AjoyDas76/Safe_Guard/vest/README.md

# 🦺 SafeGuard Vest for Industrial Workers

An IoT-based wearable safety vest powered by **ESP32**, **LoRa**, and a **solar charging system**.

## Features
- 🌡️ Environmental Monitoring (BME280)
- 📍 GPS Tracking (NEO-M8N)
- 🚶 Motion & Fall Detection (MPU6050)
- 📡 Long-range Communication (SX1278 RA-02 LoRa)
- 📲 GSM Emergency SOS SMS (SIM800L) — sends last GPS location on fall/SOS/high-temp alert
- ☀️ Solar Charging (DFRobot Solar Power Manager 5V)
- 🆘 SOS Emergency Button
- 🔋 Battery-powered wearable system

See [`VEST-CONNECTIONS.md`](./VEST-CONNECTIONS.md) for the full hardware wiring reference.

## Hardware
- ESP32 DevKit V1
- BME280
- MPU6050
- NEO-M8N GPS
- SX1278 RA-02
- SIM800L GSM
- 5V Flexible Solar Panel
- DFRobot Solar Power Manager 5V
- 18650 Li-ion Battery
- Active Buzzer
- SOS Push Button
- On/Off Switch

## Repository Structure
```
hardware/
firmware/
docs/
diagrams/
images/
results/
thesis/
datasheets/
```

## Development Roadmap
- [x] Phase 1 - Project Initialization
- [x] Phase 2 - BME280 Environmental Monitoring
- [x] Phase 3 - MPU6050 Motion & Fall Detection
- [x] Phase 4 - GPS Tracking System
- [x] Phase 5 - LoRa Communication System
- [x] Phase 6 - IoT Cloud Platform
- [x] Phase 7 - Mobile Application
- [x] Phase 8 - Smart Safety Features
- [x] Phase 9 - System Integration
- [ ] Phase 10 - Final Product Release

See `firmware/README.md` for the full phase-by-phase breakdown and status.

## Team
- Ajoy Das
- Shafiul Azam
- Ritu Biswas
- Abdullah Al Mamun
- Abdul Halim

## Project Progress

| Phase | Status |
| --- | --- |
| Phase 01 - Project Initialization | ✅ Completed |
| Phase 02 - BME280 Integartion | ✅ Completed |
| Phase 03 - MPU6050 Integration | ✅ Completed |
| Phase 04 - GPS Module Integration | ✅ Completed |
| Phase 05 - LoRa Integration | ✅ Completed |
| Phase 06 - IoT Cloud Platform | ✅ Completed |
| Phase 07 - Mobile Application | ✅ Completed |
| Phase 08 - Smart Safety Feature Integration | ✅ Completed |
| Phase 09 - Full System Integration | ✅ Completed |
| Phase 10 - Final Product Release | ⬜ Pending |

Roadmap
