AjoyDas76/Safe_Guard/final-project/README.md

# Final Project – SafeGuard Smart Industrial Safety System

This folder contains the combined, final-release deliverables for the complete **SafeGuard Smart Industrial Safety System**, integrating the **Smart Safety Vest** and **Smart Safety Helmet** into one final project package.

The purpose of this folder is to collect the materials that represent the **finished project as a whole**, rather than the individual development history of the vest and helmet sections.

## 📦 Final Project Contents

As the project is completed, this folder is intended to contain:

- 📄 **Final combined project report / thesis document**
- 🎞️ **Final presentation slides**
- 🏗️ **Consolidated system architecture diagram** covering the vest and helmet together
- 📋 **Final Bill of Materials (BOM)** for both sections
- 🧪 **Field-test results and performance summary**
- 📦 **Submission-ready project package**, such as a ZIP release
- 🎥 **Demo video links**, where applicable

## 🦺⛑️ Complete SafeGuard System

The final project represents the combined **Smart Industrial Safety System** consisting of:

- 🦺 Smart Safety Vest
- ⛑️ Smart Safety Helmet
- 📊 Combined system documentation
- 🏗️ Consolidated system architecture
- 📋 Final hardware and component documentation
- 🧪 Final testing and performance results
- 📦 Submission-ready project deliverables

## 📁 Repository Organization

The repository separates development work from the final combined deliverables:

```text
Safe_Guard/
│
├── vest/
│   └── Smart Safety Vest development
│
├── helmet/
│   └── Smart Safety Helmet development
│
└── final-project/
    └── Combined final-release deliverables
```

### `vest/`

Contains the working files for the **Smart Safety Vest**, including its firmware, wiring documentation, and phase-by-phase development history.

### `helmet/`

Contains the working files for the **Smart Safety Helmet**, including its firmware, wiring documentation, and phase-by-phase development history.

### `final-project/`

This folder is specifically reserved for the **final combined output** of the complete Smart Industrial Safety System.

## 🔄 Development vs Final Release

The `vest/` and `helmet/` folders remain the working areas for their respective sections.

Their development history, firmware, wiring documentation, and phase-by-phase work should remain organized within those folders.

The `final-project/` folder should contain only the materials required to represent and submit the **completed combined system**.

This separation keeps the repository organized while preserving the individual development history of both system sections.

## 🎓 Final Submission Package

When the project is ready for final submission, this folder should provide a single location for the major combined deliverables:

1. Final Project Report / Thesis
2. Final Presentation
3. Combined System Architecture
4. Final Bill of Materials
5. Field-Test and Performance Results
6. Submission-Ready Project Package
7. Demonstration Video Links, if available

## 📌 Project Status

The contents of this folder are intended to be populated and finalized as the complete **Smart Industrial Safety System (Vest + Helmet)** reaches its final submission stage.

> **Note:** `final-project/` is the final-release area. The `vest/` and `helmet/` folders remain the primary locations for their individual development files and phase-by-phase history.
