AjoyDas76/Safe_Guard/vest/firmware/Phase-08_Smart_Safety_Features/README.md

# Phase-08 Smart Safety Features

## Objective
Add the on-body safety hardware features to the worker unit: manual SOS button, audible/visual alarms, and power management (solar charging + battery monitoring), and finalize the safety module as a whole.

## Tasks

- [x] 8.1 SOS Button
- [x] 8.2 Buzzer Alarm
- [x] 8.3 LED Warning Indicator
- [x] 8.4 Battery Monitoring
- [x] 8.5 Power Management
- [x] 8.6 SIM800L SOS SMS (added beyond the original scope — moved here from the helmet; see Notes)
- [x] 8.7 Safety Module Finalization

## Components
- SOS Push Button
- Active Buzzer
- Status LED(s)
- SIM800L GSM module
- 18650 Li-ion Battery
- 5V Flexible Solar Panel
- DFRobot Solar Power Manager 5V

## Wiring
Finalized in `Phase-09_System_Integration/transmitter_final.ino` (pin numbers superseded the Phase 5 sketches' `BUTTON_PIN 4`):

| Feature | Pin |
|---|---|
| SOS Button (INPUT_PULLUP) | GPIO15 |
| Buzzer | GPIO12 |
| LED | GPIO13 |
| Battery monitor (ADC, via 2:1 voltage divider) | GPIO34 |
| SIM800L RX / TX | GPIO25 / GPIO27 |

Full reference: [`../../VEST-CONNECTIONS.md`](../../VEST-CONNECTIONS.md).

## Code
Implemented directly in `Phase-09_System_Integration/transmitter_final.ino` rather than as a separate standalone sketch — the alarm trigger condition (`mpuData.fall || sosActive || temp > 50.0`) drives the buzzer/LED and also triggers a SIM800L SOS SMS (with the worker's last GPS location) via `sendSOSMessage()`, cooldown-limited to 60s.

## Test Results
SOS button, buzzer, LED, and battery monitoring confirmed working as part of the finalized transmitter firmware. SIM800L SMS sending is implemented but **not yet confirmed end-to-end** — `EMERGENCY_NUMBER` in `transmitter_final.ino` is still a placeholder (`+8801XXXXXXXXX`) and needs a real number before this can be tested.

## Notes
- This phase merges what were previously two separate, empty placeholder folders (`Phase-06_Power_System` and `Phase-07_SOS`) into one, matching the updated roadmap.
- Buzzer Alarm (8.2) and LED Warning (8.3) trigger on **SOS**, **FALL_DETECTED**, and high-temperature states.
- SIM800L SOS SMS (8.6) was originally planned for the helmet, but was moved here during development — an emergency SMS is more useful carrying the vest's GPS location and confirmed fall/SOS status than helmet-only sensor data. See the helmet repo's `Phase-08_SIM800L_GSM_SOS/README.md` for that history.

## Status

✅ **Completed** (SOS button, buzzer, LED, battery monitoring, power management all working) — ⚠️ SIM800L SMS still needs a real `EMERGENCY_NUMBER` filled in before it's functional.
