AjoyDas76/Safe_Guard/helmet/firmware/Phase-09_DualNano_Integration/README.md

# Phase 9 — Dual-Nano System Integration

**Status: ✅ Tested and confirmed working** as a complete combined system — verified via live data populating correctly on the Firebase/website dashboard (obstacle, gas, heart rate, SpO2 all updating in real time).

This is the full combined firmware (v3/final), with the logic from Phases 2, 3, 4, and 6 integrated into `Nano1_SensorNode.ino`, and Phase 7 (ESP-01 WiFi forwarding) in `Nano2_CommNode.ino`. The v3 version adds debouncing, gas-sensor smoothing/hysteresis, and vitals freshness checks on top of the original logic, plus sends per-sensor ultrasonic distances and raw gas readings (not just overall alert flags) for richer dashboard display.

> **SIM800L GSM SOS has moved to the vest** (see `vest/firmware/Phase-09_System_Integration/transmitter_final.ino`) — the helmet no longer sends SMS/calls. See the note at the top of `Nano2_CommNode.ino` for the reasoning.

## Files
- `Nano1_SensorNode.ino` — all sensors + local alerts (Ultrasonic x3, MQ-2, MAX30100, Buzzer x2, Vibration Motor)
- `Nano2_CommNode.ino` — WiFi forwarding only (ESP-01 → Firebase)

## Full wiring

**Nano #1 — Sensor Node**

| Module | Pin |
|---|---|
| Ultrasonic 1 (Front) | Trig D2, Echo D3 |
| Ultrasonic 2 (Left) | Trig D4, Echo D5 |
| Ultrasonic 3 (Right) | Trig D6, Echo D7 |
| Buzzer 1 (obstacle — active, beep-beep pattern) | D8 |
| Buzzer 2 (gas/health — passive, ambulance-style siren tone) | D9 |
| MQ-2 | A0 |
| MAX30100 (I2C) | SDA A4, SCL A5 |
| Vibration Motor | D13 -> transistor (powered via AMS1117, not direct 5V) |
| Link to Nano #2 | D10 (RX), D11 (TX) — SoftwareSerial |

**Nano #2 — Communication Node**

| Module | Pin |
|---|---|
| Link from Nano #1 | D4 (RX) — SoftwareSerial, wired to Nano #1's D11 |
| ESP-01 adapter | D2 (RX), D3 (TX) — SoftwareSerial, crossed with the adapter's TX/RX |

All grounds (both Nanos, ESP-01 adapter) must be common. D0/D1 are deliberately left unused on Nano #2 so USB upload and Serial Monitor always work without disconnecting anything.

> The LDR + 3-LED headlamp array is **not** part of this firmware — it's a separate, independent relay-controlled circuit (see `Phase-05_LDR_Headlamp_Relay/`).

## Before uploading
- No wires need to be disconnected before uploading to either Nano — the Nano #1-to-#2 link uses D4 on Nano #2, not D0, specifically so this isn't necessary.
- `OBSTACLE_THRESHOLD_CM` is set to 50cm (tuned down from an initial 100cm). `GAS_MARGIN` and heart rate/SpO2 ranges are starting points — tune further after physical testing if needed.
- `Nano2_CommNode.ino` expects the ESP-01 to be running `Phase-07_ESP01_WiFi_Firebase/ESP01_WiFi_Firebase.ino` already flashed and in standalone mode (not AT-command mode).
