AjoyDas76/Safe_Guard/helmet/firmware/Phase-03_MQ_Gas_Sensor/README.md

# Phase 3 — MQ Gas Sensor Threshold & Alert Logic

Standalone verification: see `Phase-01_Component_Verification/MQ2_Gas_Test.ino`.

The clean-air baseline calibration and threshold-based gas alert logic is implemented directly in the combined firmware at `Phase-09_DualNano_Integration/Nano1_SensorNode.ino`, rather than as a separate standalone sketch.
