AjoyDas76/Safe_Guard/helmet/HELMET-CONNECTIONS.md

# SafeGuard Helmet — Hardware Connections

Full wiring reference for both Arduino Nano units in the helmet, plus the independent LDR/relay headlamp circuit. Pin numbers below match the finalized integration firmware (`firmware/Phase-09_DualNano_Integration/Nano1_SensorNode.ino` and `Nano2_CommNode.ino`).

---

## System Overview

```mermaid
graph LR
    S[Sensors:<br/>Ultrasonic x3, MQ-2, MAX30100] --> N1[Nano #1<br/>Sensor Node]
    N1 -- local alerts --> A[Buzzer x2, Vibration Motor]
    N1 -- Serial D11 to D4 --> N2[Nano #2<br/>Communication Node]
    N2 -- WiFi --> ESP[ESP-01]
    ESP --> FB[(Firebase /helmet1)]

    LDR[LDR] -.independent circuit.-> REL[Relay]
    REL -.-> LED[3x White LED Headlamp]
```

> The LDR + LED headlamp is a **separate, independent circuit** — it is not wired to either Nano. See §3.
>
> **SIM800L GSM SOS is not on the helmet** — it has been moved to the vest, since an emergency SMS is far more useful carrying the worker's GPS location and fall/SOS status, both of which live on the vest's sensors. See `vest/VEST-CONNECTIONS.md` §1.5 for the current implementation.

---

## 1. Nano #1 — Sensor Node

### 1.1 Component list
Ultrasonic ×3, MQ-2 gas sensor, GY-30100 (MAX30100), Buzzer ×2 (1 active, 1 passive), miniature vibration motor (via NPN transistor + AMS1117 regulator).

### 1.2 Pin connection table

| Subsystem | Pin | Nano #1 |
|---|---|---|
| **Ultrasonic 1 (Front)** | Trig | D2 |
| | Echo | D3 |
| **Ultrasonic 2 (Left)** | Trig | D4 |
| | Echo | D5 |
| **Ultrasonic 3 (Right)** | Trig | D6 |
| | Echo | D7 |
| **MQ-2** | AO (analog) | A0 |
| | VCC | 5V |
| | GND | GND |
| **MAX30100 (GY-30100)** | SDA | A4 |
| | SCL | A5 |
| | VCC | 5V (or 3.3V per module) |
| | GND | GND |
| **Buzzer 1** (active — obstacle alert, beep-beep pattern) | Signal | D8 |
| **Buzzer 2** (passive — gas/health alert, ambulance-style siren tone via `tone()`) | Signal | D9 |
| **Vibration motor** | Control (via transistor base) | D13 |
| **Link to Nano #2** | RX / TX (SoftwareSerial) | D10 / D11 |

### 1.3 Vibration motor driver circuit
The motor cannot run directly off 5V (confirmed — it gets damaged). Drive it through an NPN transistor, powered from a separate AMS1117-regulated rail:

```mermaid
graph LR
    D13[Nano D13] -->|1k resistor| B[Transistor Base]
    B --> C[Transistor]
    C -->|Collector| M[Motor -]
    AMS[AMS1117 output] --> MP[Motor +]
    C -->|Emitter| GND[GND]
    MP -.flyback diode 1N4007.-> C
```

---

## 2. Nano #2 — Communication Node

### 2.1 Component list
ESP-01 (via HW-580 adapter board). *(SIM800L is no longer on the helmet — see note above.)*

### 2.2 Pin connection table

| Subsystem | Pin | Nano #2 |
|---|---|---|
| **Link from Nano #1** | RX (SoftwareSerial) | D4 — wired to Nano #1's D11 |
| **ESP-01 adapter (HW-580)** | Adapter TX → Nano RX | D2 |
| | Adapter RX ← Nano TX | D3 |
| | Adapter VCC | 5V |
| | Adapter GND | GND |

D0/D1 (now left free for USB) and D6/D7 (previously used for SIM800L) are all free.

> **ESP-01 note:** the HW-580 adapter has its own onboard 3.3V regulator and TX/RX level shifting, so it takes 5V directly from Nano #2 — no separate AMS1117 or voltage dividers needed for it.

### 2.3 Before uploading to Nano #2
The link from Nano #1 now uses D4 (SoftwareSerial) instead of D0 — this was changed specifically so that **D0/D1 stay free for USB upload and Serial Monitor at all times**. No wires need to be disconnected before uploading new code to Nano #2.

---

## 3. LDR + LED Headlamp (Independent Circuit — Not Connected to Either Nano)

The LDR does **not** connect to any Arduino. It's a self-contained circuit with its own power source:

```mermaid
graph LR
    PWR[Independent power source] --> LDR[LDR circuit]
    LDR -- dark detected --> REL[Relay]
    REL -- switches --> LED1[LED 1]
    REL -- switches --> LED2[LED 2]
    REL -- switches --> LED3[LED 3]
```

All three white LEDs are wired in parallel (each with its own current-limiting resistor) and switched together by the relay. In darkness, the relay closes and all three turn on together as a single headlamp array — there is no separate status/warning LED in this design. Verification is visual only (relay click + LEDs on/off with ambient light) — no firmware test applies here.

---

## 4. Power Summary

| Rail | Powers | Source |
|---|---|---|
| 5V | Both Nanos, Ultrasonic ×3, MQ-2, MAX30100, Buzzer ×2, ESP-01 adapter | Main 5V supply |
| AMS1117-regulated | Vibration motor | Separate regulator off the main supply |
| Independent | LDR + relay + LED headlamp array | Its own separate power source, unrelated to the Nanos |

Removing SIM800L from the helmet also removes its power/brownout risk from this system — that concern now applies to the vest instead (see `vest/VEST-CONNECTIONS.md` §1.5), where it's a better fit since SIM800L can run off the vest's existing 18650/solar power system.

---

## 5. Software Connections (No Wiring)

- **WiFi:** ESP-01 connects to the local router (2.4GHz only)
- **Firebase Realtime Database:** `worker-safety-vest-92b97-default-rtdb.firebaseio.com`, writing to `/helmet1/live` (latest status) and `/helmet1/logs` (timestamped history) — same project as the vest, kept in a separate node

---

## ⚠️ Before pushing this repo publicly

`Phase-08_SIM800L_GSM_SOS/sim800l_call_test.ino` and `sim800l_msg_test.ino` (kept as historical bench-test records, no longer part of the active helmet firmware — see that folder's README) still have a real phone number hardcoded. The active `EMERGENCY_NUMBER` now lives in `vest/firmware/Phase-09_System_Integration/transmitter_final.ino` and needs the same treatment. Move all of these into a separate, `.gitignore`d config file before the repo goes public — same practice already recommended for the vest's WiFi credentials.

---

## Notes
- Pin numbers above are from the **finalized Phase 9 integration firmware** — the source of truth for the physical build, same convention as `VEST-CONNECTIONS.md`.
- This firmware (v3/final) has been tested and confirmed working as a complete combined system (all sensors + both Nanos + ESP-01 running together) — verified via live data populating correctly on the Firebase dashboard.
- SIM800L GSM SOS has moved to the vest — see `vest/VEST-CONNECTIONS.md` §1.5.
