AjoyDas76/Safe_Guard/vest/firmware/README.md

# firmware

ESP32 firmware for the Smart Safety Vest, organized by development phase.

| Phase | Folder | Status |
|---|---|---|
| 01 - Project Initialization | `Phase-01_ESP32_Setup/` | ✅ Completed |
| 02 - Environmental Monitoring (BME280) | `Phase-02_BME280/` | ✅ Completed |
| 03 - MPU6050 Motion & Fall Detection | `Phase-03_MPU6050/` | ✅ Completed |
| 04 - GPS Tracking System | `Phase-04_GPS/` | ✅ Completed |
| 05 - LoRa Communication System | `Phase-05_LoRa/` | ✅ Completed |
| 06 - IoT Cloud Platform | `Phase-06_IoT_Cloud_Platform/` | ✅ Completed |
| 07 - Mobile Application | `Phase-07_Mobile_Application/` | ✅ Completed |
| 08 - Smart Safety Features | `Phase-08_Smart_Safety_Features/` | ✅ Completed |
| 09 - System Integration | `Phase-09_System_Integration/` | ✅ Completed |
| 10 - Final Product Release | `Phase-10_Final_Product_Release/` | ⬜ Pending |

Each phase folder has its own `README.md` with objective, wiring, task checklist, and status.
