AjoyDas76/Safe_Guard/final-project/safeguard-app-final/AI_INTEGRATION.md

# SafeGuard অ্যাপে AI ফিচার (ওয়েব থেকে পোর্ট)

ওয়েবসাইটের দুটো AI ফিচার এখন অ্যাপেও আছে, নেভিগেশন ড্রয়ারে দুটো নতুন স্ক্রিন হিসেবে:

| স্ক্রিন | ওয়েবে কী ছিল |
|---|---|
| **Ask SafeGuard** | চ্যাট উইজেট — "আজকে কয়টা অ্যালার্ট হয়েছে?", "ওয়ার্কারের অবস্থা এখন কেমন?" ইত্যাদি (বাংলা/English) |
| **AI Analyze** | AI Anomaly Analysis — 1H/6H/24H/7D, ANALYZE বাটন, চার্ট, FINDINGS |

কোনো API কী, সার্ভার বা খরচ লাগে না। সব হিসাব ফোনেই হয় এবং প্রতিটি সংখ্যা আসল ডেটা থেকে গণনা করা (hallucination নেই) — ঠিক ওয়েবের মতো।

## নতুন / পরিবর্তিত ফাইল

```
app/src/main/java/com/example/ai/
  SGEngine.kt            ← ai-engine.js-এর Kotlin পোর্ট (অ্যালার্ট, ইনসিডেন্ট গ্রুপিং, অ্যানোমালি ডিটেকশন)
  SGIntent.kt            ← বাংলা/English প্রশ্ন বোঝা (detectIntent, parseScope)
  AskEngine.kt           ← চ্যাটের উত্তর বানানো (ai-ui.js-এর handler-গুলো)
  FirebaseAiDataSource.kt← অ্যাপের আসল ডেটার সাথে সংযোগ (শুধু READ, Firebase-এ কিছু লেখে না)
  AiUiState.kt           ← চ্যাট হিস্ট্রি / শেষ বিশ্লেষণ ধরে রাখা
app/src/main/java/com/example/ui/screens/
  AiAssistantScreen.kt   ← Ask SafeGuard UI
  AiAnalysisScreen.kt    ← AI Analyze UI (কার্ড, চার্ট, findings)
  MainScaffold.kt        ← (পরিবর্তিত) ড্রয়ারে ২টি নতুন আইটেম + নেভিগেশন
app/src/test/java/com/example/ai/
  SGEngineTest.kt        ← JVM ইউনিট টেস্ট
```

`SGEngine.kt`, `SGIntent.kt`, `AskEngine.kt` — এই তিনটিতে কোনো Android/Firebase import নেই। তাই JVM-এ টেস্ট করা যায়।

## ওয়েব থেকে ইচ্ছাকৃত ৩টি পার্থক্য

1. **থ্রেশহোল্ড ফিক্সড নয়।** ওয়েবে সীমাগুলো কোডে স্থির (তাপমাত্রা 15–45 ইত্যাদি)। অ্যাপে ব্যবহারকারী *Safety Rules* স্ক্রিন থেকে সীমা বদলাতে পারে। তাই AI সেই বর্তমান সীমা ব্যবহার করে — যাতে AI আর অ্যাপের নিজস্ব অ্যালার্ট একমত থাকে। ("ফিক্সড থ্রেশহোল্ড মিস করত" = Safety Rules-এর বর্তমান সীমা মিস করত।)
2. **ভেস্টের লগ `/worker1/logs` থেকে পড়া হয় (ওয়েবের মতোই)।** অ্যাপের পুরোনো `VestTelemetryManager.fetchHistory()` পড়ে `/worker1/history` এবং ডেটা না থাকলে **নকল (synthetic) ডেটা** বানায়। AI-কে নকল ডেটায় চালানো ভুল সিদ্ধান্ত দেবে, তাই AI সরাসরি আসল লগ পড়ে।
3. **সিমুলেশন মোড সতর্কতা।** অ্যাপের ডেমো/সিমুলেশন মোড চালু থাকলে লাইভ উত্তরে স্পষ্ট লেখা আসে: "লাইভ মানগুলো আসল নয়"।

## যাচাই — কী করা হয়েছে, কী হয়নি

**করা হয়েছে:**
- একই সিন্থেটিক ডেটা (লাফ, ট্রেন্ড, আটকে যাওয়া সেন্সর, ডেটা গ্যাপ, শুয়ে থাকা, হিট-স্ট্রেস, গ্যাস স্পাইক, পূর্বাভাস) ওয়েবের `ai-engine.js` আর Kotlin ইঞ্জিন — দুটোতে চালিয়ে মেলানো হয়েছে: **৩৬ লাইন আউটপুট (বাংলা/English টেক্সট, σ, slope, ইনসিডেন্ট সহ) এবং ২০টি প্রশ্নের intent — হুবহু এক।**
- চ্যাট-লেয়ার নকল ডেটা সোর্সে চালিয়ে বাংলা/English উত্তর, বাটন, সিমুলেশন সতর্কতা দেখা হয়েছে।
- `SGEngineTest.kt`-এর ৬টি টেস্টের অ্যাসার্শন JVM-এ চালানো হয়েছে — সব পাস (editable থ্রেশহোল্ড বদলালে অ্যালার্ট বদলায়, ইনসিডেন্ট গ্রুপিং, flat-line, inactivity, বাংলা/English intent, JS `toFixed`-এর সাথে সংখ্যা-ফরম্যাট মিল)।

**এখনো হয়নি (আপনার Android Studio-তে করতে হবে):**
- Gradle বিল্ড: Compose স্ক্রিন (`Ai*Screen.kt`), `FirebaseAiDataSource.kt` ও `MainScaffold.kt`-এর পরিবর্তন আমি কম্পাইল করতে পারিনি (স্যান্ডবক্সে Android SDK/Google Maven নেই)। সিনট্যাক্স পার্সার দিয়ে দেখা হয়েছে, কিন্তু সম্পূর্ণ টাইপ-চেক Android Studio-তেই হবে। কোনো ছোট কম্পাইল এরর এলে আমাকে এররটা দিন, ঠিক করে দেব।
- আসল ডিভাইসে UI/UX দেখা এবং আসল Firebase ডেটায় চালানো।

## পরবর্তী ধাপ (প্রস্তাবিত)

1. **ফলাফল Excel/PDF-এ এক্সপোর্ট** — ওয়েবে "Export findings (Excel)" আছে; অ্যাপে বিদ্যমান `ExcelExporter`/`PdfReportExporter` কাজে লাগানো যাবে।
2. **ঐচ্ছিক Gemini ফলব্যাক** — ইঞ্জিন যে প্রশ্ন বোঝে না সেগুলোর জন্য। অ্যাপে `firebase-ai` ডিপেন্ডেন্সি আগে থেকেই আছে (Firebase AI Logic), তাই ব্যবহারকারীকে কী পেস্ট করাতে হবে না। App Check ও Firebase কনসোল সেটআপ লাগবে। ডিফল্টে বন্ধ রাখা ভালো।
3. **ব্যাকগ্রাউন্ড AI নোটিফিকেশন** — যেমন "তাপমাত্রা এই হারে বাড়লে ~৯ মিনিটে সীমা ছুঁবে"। ওয়েবে এটা ইচ্ছাকৃতভাবে ম্যানুয়াল। অ্যাপে অটো চালালে ব্যাটারি/ফলস-অ্যালার্মের ব্যাপারটা আগে ঠিক করতে হবে।
4. **প্যারামিটার টিউনিং** — `METRICS`/`CFG` (SGEngine.kt) আপনাদের রেকর্ড করা আসল ডেটা দিয়ে ঠিক করা, বিশেষ করে হার্ট রেট।

## ফ্লোটিং "Ask SafeGuard" বাটন (ওয়েবের মতো)

লগইনের পর সব স্ক্রিনেই নিচে-ডানে ফ্লোটিং **Ask SafeGuard** বাটন দেখা যায়। চাপলে বর্তমান পেইজের ওপরেই চ্যাট প্যানেল খোলে (পেইজ বদলায় না); 

- বাটন **ড্র্যাগ করে সরানো যায়** (যেমন ম্যাপের নিচের প্যানেল ঢাকলে); নতুন জায়গা সব স্ক্রিনে একই থাকে।
- লুকানো থাকে: প্যানেল খোলা থাকলে ও কীবোর্ড খোলা থাকলে।
- ড্রয়ার/নেভিগেশন মেনুতে আর "Ask SafeGuard" আইটেম নেই — চ্যাট শুধু ফ্লোটিং বাটন থেকে খোলে।
- প্যানেল বন্ধ: X বাটন, বাইরে চাপ, বা Back।
- ফাইল: `ui/components/AskSafeGuardFab.kt` (নতুন), `MainScaffold.kt`, `AiAssistantScreen.kt` (`onClose`, `handleIme` প্যারামিটার), `AiUiState.kt` (`fabX/fabY`)।

## ড্যাশবোর্ড কার্ডে নিয়ন গ্লো (ওয়েবের মতো)

ড্যাশবোর্ডের প্রতিটি কার্ডের চারপাশে ওয়েবের হোভার-গ্লোর মতো নিয়ন আলো স্থায়ীভাবে জ্বলে (ফোনে হোভার নেই বলে)। রং কার্ড অনুযায়ী: Temperature/Heart Rate/Active Alerts = লাল, Pressure = বেগুনি, Humidity/Blood Oxygen/Worker Status/Diagnostics/Event History/Alerts/Proximity = সায়ান, Motion = অ্যাম্বার, Gas/Obstacle = তাদের নিজস্ব হলুদ-অ্যাম্বার। কার্ড ওয়ার্নিং অবস্থায় গেলে গ্লো লাল হয়।

- `WebGlass.kt`: নতুন `Modifier.webNeonGlow(...)` এবং `webGlass(..., glow = রং)` প্যারামিটার। গ্লো শুধু কার্ডের **বাইরে** আঁকা হয়, তাই স্বচ্ছ কার্ডের ভেতরে ঢোকে না।
- `DashboardScreen.kt`: পাশের 12dp প্যাডিং `LazyColumn`-এর `contentPadding`-এ সরানো হয়েছে, নইলে গ্লো স্ক্রিনের কিনারায় কেটে যেত।
- অন্য স্ক্রিনের কার্ড (Alerts, Report ইত্যাদি) বদলায়নি; চাইলে সেখানে `glow = ...` যোগ করলেই হয়।

## পারফরম্যান্স (লো-এন্ড ফোনের জন্য)

- **R8 + রিসোর্স শ্রিংকিং চালু** (`build.gradle.kts` release): APK ছোট, স্টার্টআপ দ্রুত। keep rules `proguard-rules.pro`-তে। **রিলিজ বিল্ড দিয়ে সব স্ক্রিন একবার ঘুরে দেখুন** (Dashboard, Live Chart, Map, Alerts, Report/Excel/PDF এক্সপোর্ট, লগইন) — কোথাও ক্র্যাশ হলে Logcat-এর `ClassNotFoundException`/`NoSuchMethodError` দেখে rule যোগ করতে হবে।
- **Baseline Profile:** `src/main/baseline-prof.txt` (হাতে লেখা, `com.example.**` সব কভার করে) + `profileinstaller` ডিপেন্ডেন্সি।
- `OnlineStatusPill`-এর অব্যবহৃত অসীম অ্যানিমেশন সরানো হয়েছে।
- Live Chart-এর LIVE ডটের পালস এখন ড্র ফেজে পড়া হয় (পুরো স্ক্রিন রিকম্পোজ হয় না)।
- Dashboard: ওপরে ৬টা ফ্লো একসাথে কালেক্ট না করে প্রতিটি কার্ড নিজের দরকারি ফ্লো কালেক্ট করে; তাই Firebase আপডেটে শুধু বদলানো কার্ড রিকম্পোজ হয়। Motion কার্ড ও Event History-র online ফ্ল্যাগ `derivedStateOf` দিয়ে শুধু মান বদলালে আপডেট হয়।
- **পারফরম্যান্স সবসময় রিলিজ বিল্ডে মাপুন** — ডিবাগ বিল্ডে Compose কয়েক গুণ ধীর।
