AjoyDas76/Safe_Guard/helmet/firmware/Phase-10_Final_Testing_Documentation/README.md

# Phase 10 — Final Field Testing & Documentation

Pending — full-system field testing on the physical helmet (with all modules from Phase 9 running together), threshold tuning based on real results, and final documentation.
