AjoyDas76/Safe_Guard/(commit log)

2026-10-02 Revise component verification status in README
    Updated verification status for SIM800L GSM and LDR + LED headlamp components in the README.
2026-10-02 Revise features section in README.md
    Updated features section to highlight key features of smart safety devices.
2026-10-07 Update print statement from 'Hello' to 'Goodbye'
2026-10-07 Refactor buzzer handling in Nano1_SensorNode
    Removed buzzer management logic and simplified alert handling.
    [Nano1_SensorNode.ino]
2026-10-08 Update helmet connections and remove SIM800L module
    Removed SIM800L GSM module from helmet connections and updated related notes. Clarified buzzer descriptions and adjusted power summary accordingly.
2026-10-08 Reduce obstacle detection threshold to 50 cm
2026-10-08 Adjust obstacle threshold and implement buzzer alerts
    Updated obstacle detection threshold and added buzzer functionality for alerts.
    [Nano1_SensorNode.ino]
2026-10-09 Refactor Nano1_SensorNode for improved functionality
    Updated Nano1_SensorNode to version 3 with enhanced data reporting. Adjusted sensor pin definitions and improved alert logic for gas and health monitoring.
2026-10-10 Update fmt.Println message from 'Hello' to 'Goodbye'
2026-10-10 Enhance helmet monitoring features in index.html
    Updated the HTML file to include additional helmet sensor metrics and charts, enhanced the description meta tag, and modified the alerts and reports sections to accommodate helmet-related data.
2026-10-10 Add helmet history tracking and update export logic
    Added helmetHistory to track helmet readings alongside dataHistory. Updated export functionality to include helmet data in the exported file.
2026-10-10 Change firebaseSend to PATCH for live snapshots
    Updated firebaseSend method to use PATCH instead of PUT for live snapshots to prevent overwriting history logs.
    [receiver_final.ino]
2026-10-10 Implement packet rejection for invalid sensor values
    Added validation for sensor values and tracking of rejected packets.
2026-10-13 Add AI analysis buttons and scripts to index.html
2026-10-14 Update button labels in mobile navigation
2026-10-14 Implement mobile header layout and styles
    Added responsive styles for mobile header layout and button configuration.
2026-10-24 Revise connection details and firmware status in documentation
    Updated pin connections and clarified upload process for Nano #2. Confirmed firmware functionality with all components.
2026-10-24 Finalize README for Smart Safety Features
    Updated README to reflect completed tasks and finalized wiring for safety features. Added details about SIM800L SMS implementation and test results.
